dzalf/Arduino-PID-Control-for-Isothermal-Chamber/Arduino-Code/Readme.md

This code is Ver. 0.3 

Developed based on the tutorial for NTC thermistors by Joseph Corletto

https://www.allaboutcircuits.com/projects/measuring-temperature-with-an-ntc-thermistor/
