dzalf/Arduino-PID-Control-for-Isothermal-Chamber/PCB-files/frontPanel.jpg

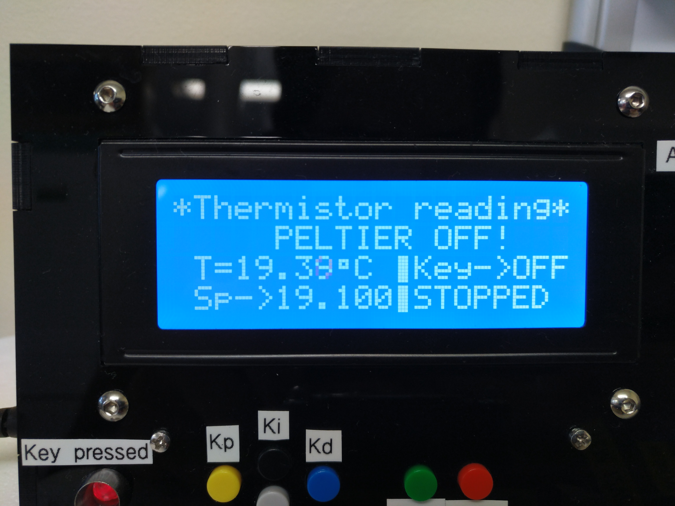
PCB-files/frontPanel.jpg
