dzalf/Arduino-PID-Control-for-Isothermal-Chamber/PCB-files/Schematic.png

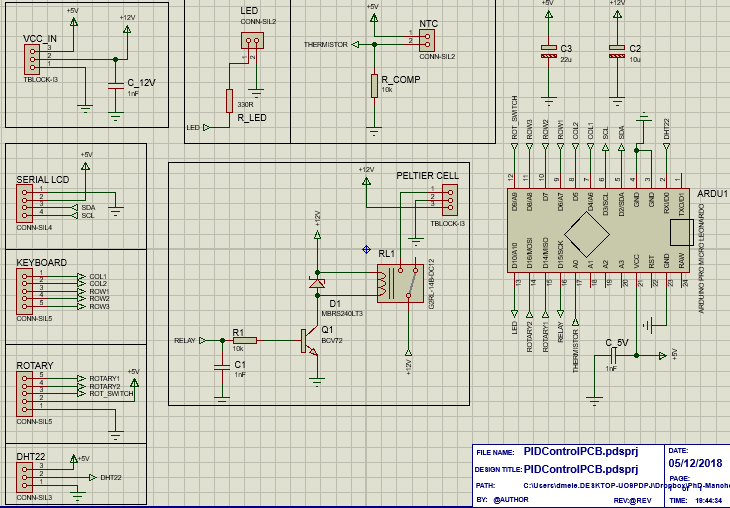
PCB-files/Schematic.png
