dzalf/Arduino-PID-Control-for-Isothermal-Chamber/PCB-files/PIDControlPCB.PDF

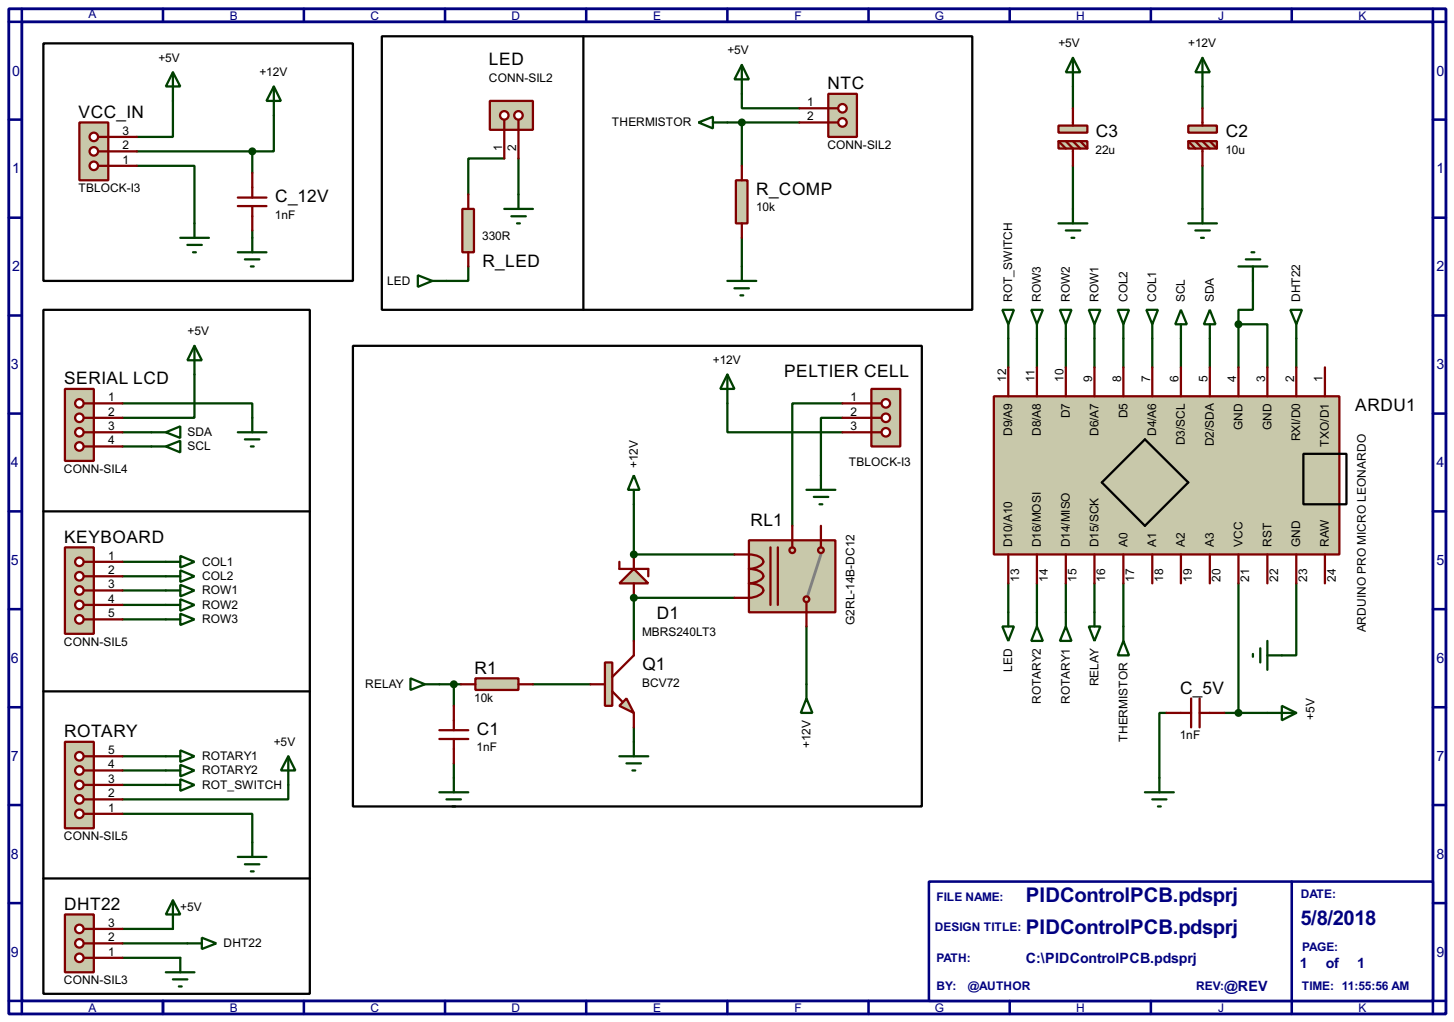
[picture p5: page 1]
