dzalf/Arduino-PID-Control-for-Isothermal-Chamber/(list of files, drawings)

Other design files:
PCB-files/PIDControlPCB.pdsprj
