dzalf/Arduino-PID-Control-for-Isothermal-Chamber/(commit log)

2018-10-18 Add files via upload
    PCB ans schematic created on Proteus 8.6
    [PIDControlPCB.pdsprj]
2018-10-18 Arduino Code for Temperature Control
    This version is based on the PCB created for the thermal control
2018-10-18 Create PCB-Files
    PCB and schematic created using Proteus 8.6
2018-10-18 Add files via upload
    Schematic and PCB files created in Proteus 8.6
    [PIDControlPCB.pdsprj]
2018-10-18 Changed the number of samples to be taken
    Increased the samples and added more comments
